iluvtaho/mine-sweeper-robot/(commit log)

2026-08-12 Revise README with power supply and trial updates
    Updated power supply details and improved trial observations. Enhanced clarity on robot's performance and engineering iterations.
2026-08-12 Modify motor speeds and buzzer settings
    Adjusted motor speeds and buzzer volume for better performance.
    [Metal_Detecting_Robot.ino]
2026-08-12 Add opposite direction turns for motors
